RepRapLtd/Duet/Duet-1.0/moved-buck-peripherals_1024.png

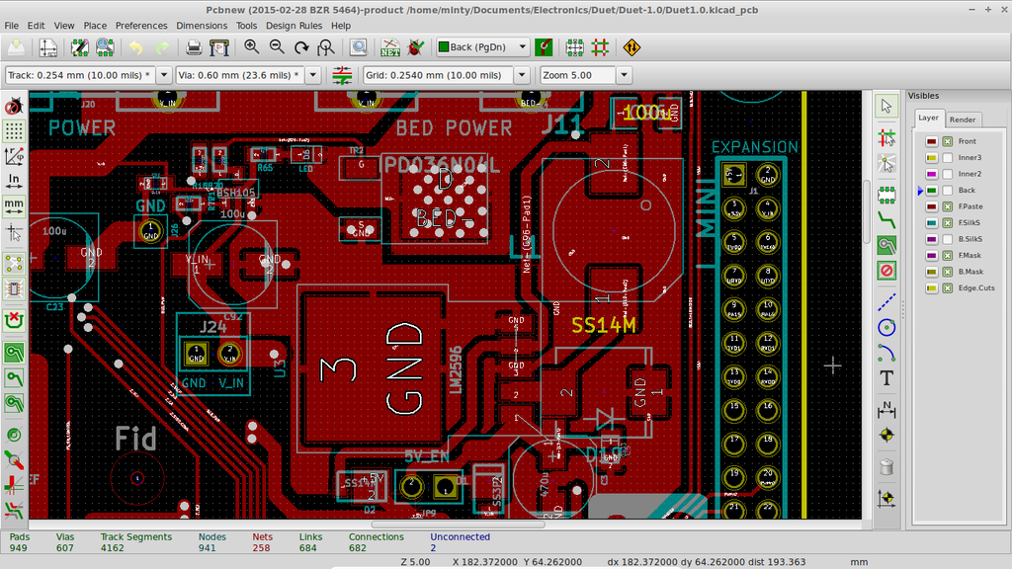
Duet-1.0/moved-buck-peripherals_1024.png
