RepRapLtd/Duet/Duet-1.0/buck-close-up.png

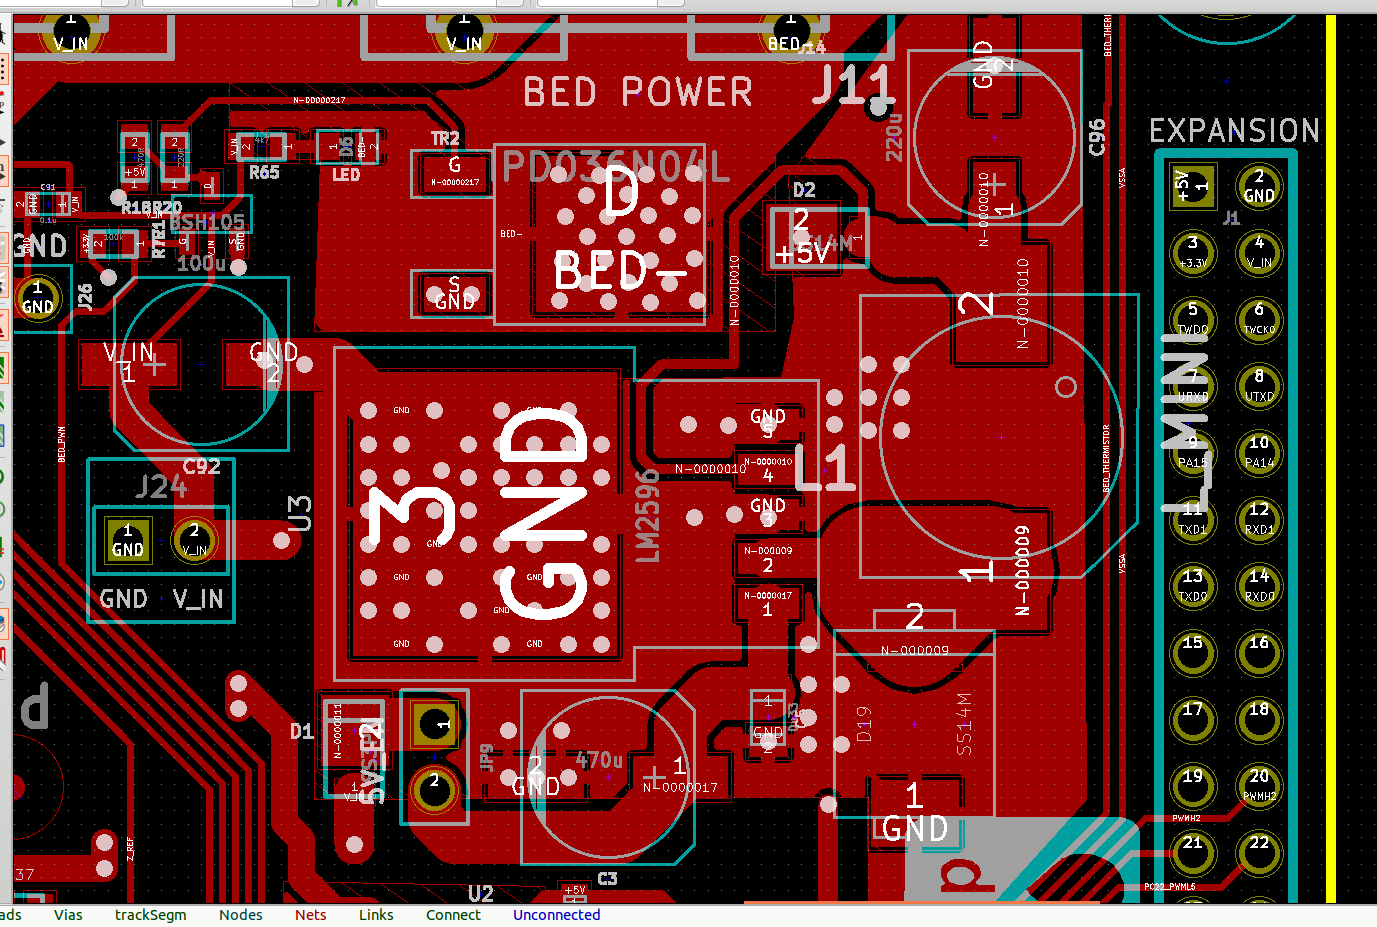
Duet-1.0/buck-close-up.png
