RepRapLtd/Duet/Duet-1.0/Duet1.0.csv

C1 | 10u | C_0805
C2 | 0u01 | C_0603
C3 | 220u | C_ELEC_10
C4 | 10u | C_0805
C5 | 0.33u | C_0805
C6 | 47n | C_0603
C7 | 10u | C_0805
C8 | 22p | C_0603
C9 | 22p | C_0603
C10 | 22u | C_1210
C11 | 22u | C_1210
C12 | 2u2 | C_0805
C13 | 1u | C_0603
C14 | 0u1 | C_0603
C15 | 0u1 | C_0603
C16 | 0u1 | C_0603
C17 | 0u1 | C_0603
C18 | 10u | C_0805
C19 | 10u | C_0805
C20 | 0u22 | C_0603
C21 | 0u22 | C_0603
C22 | 100u | C_ELEC_6.3x7.7
C23 | 100u | C_ELEC_6.3x7.7
C24 | 0u1 | C_0603
C25 | 0u1 | C_0603
C26 | 0u22 | C_0603
C27 | 0u22 | C_0603
C28 | 0u1 | C_0603
C29 | 0u1 | C_0603
C30 | 0u22 | C_0603
C31 | 0u22 | C_0603
C32 | 100u | C_ELEC_6.3x7.7
C33 | 100u | C_ELEC_6.3x7.7
C34 | 0u1 | C_0603
C35 | 0u1 | C_0603
C36 | 0u22 | C_0603
C37 | 0u22 | C_0603
C38 | 0u1 | C_0603
C39 | 0u1 | C_0603
C40 | 0u1 | C_0603
C41 | 0u1 | C_0603
C42 | 0u1 | C_0603
C43 | 0u1 | C_0603
C44 | 10p | C_0603
C45 | 10p | C_0603
C46 | 0u1 | C_0603
C47 | 10u | C_0805
C48 | 0u1 | C_0603
C49 | 0u1 | C_0603
C50 | 0u1 | C_0603
C51 | 0u1 | C_0603
C52 | 0u1 | C_0603
C53 | 0u1 | C_0603
C54 | 47n | C_0603
C55 | 0u1 | C_0603
C56 | 0u1 | C_0603
C57 | 0u1 | C_0603
C58 | 2u2 | C_0805
C59 | 4u7 | C_0805
C60 | 0u1 | C_0603
C61 | 4u7 | C_0805
C62 | 0u1 | C_0603
C63 | 47n | C_0603
C64 | 0u1 | C_0603
C65 | 10p | C_0603
C66 | 4u7 | C_0805
C67 | 0u1 | C_0603
C68 | 4u7 | C_0805
C69 | 0u1 | C_0603
C70 | 0u1 | C_0603
C71 | 0u1 | C_0603
C72 | 0u1 | C_0603
C73 | 47n | C_0603
C74 | 47n | C_0603
C75 | 0u1 | C_0603
C76 | 0u1 | C_0603
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
U3 | LM2596 | TO-263-5
U4 | KSZ8051RNL | QFN32-5x5
U5 | A4982SLPTR | TSSOP-24
U6 | A4982SLPTR | TSSOP-24
U7 | A4982SLPTR | TSSOP-24
U8 | A4982SLPTR | TSSOP-24
U9 | MCP44X1 | TSSOP-20
U10 | SP2525A-1 | SOIC-8
X1 | CRYSTAL_4PIN | Xtal_5x3.2
X2 | CRYSTAL_4PIN | Xtal_5x3.2
