RepRapLtd/Duet/Duet-0.8/component-locations.txt

Erase and Reset: http://uk.mouser.com/ProductDetail/CK-Components/KMS221G-LFS/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
