RepRapLtd/Duet/Duet-1.0/Comms.sch

## KiCad design Duet-1.0/Comms.sch (2015-10-17)

Schematic: Comms.sch

Parts:
C7: 10u
C8, C9: 22p
C10, C11: 22u
C12, C58: 2u2
C13: 1u
C16, C17, C53: 0u1
D3: LED
D4, D5: TS4148
J15: uSDHC
J19: ETHERNET
J29: USB
L2: Ferrite Bead; 1206
R1: 680R
R2, R3: 39R 1%
R4, R5: 10k; 0603
R6, R7, R8, R9, R10: 33R; 0603
R11, R13: 1k; 0603
R12, R14: 4k7; 0603
R15: 6k49 1%; 0603
R16, R17: 220R; 0603
R53: 100k
R63, R64: 10K; 0603
R73, R74, R75, R76: 47K; 0603
R83: 0R
U4: KSZ8051RNL
U10: SP2525A-1
X1: CRYSTAL_4PIN

Notes on the sheet:
uSD
ETHERNET
USB
