RepRapLtd/Duet/Duet-1.0/Headers.sch

## KiCad design Duet-1.0/Headers.sch (2015-10-17)

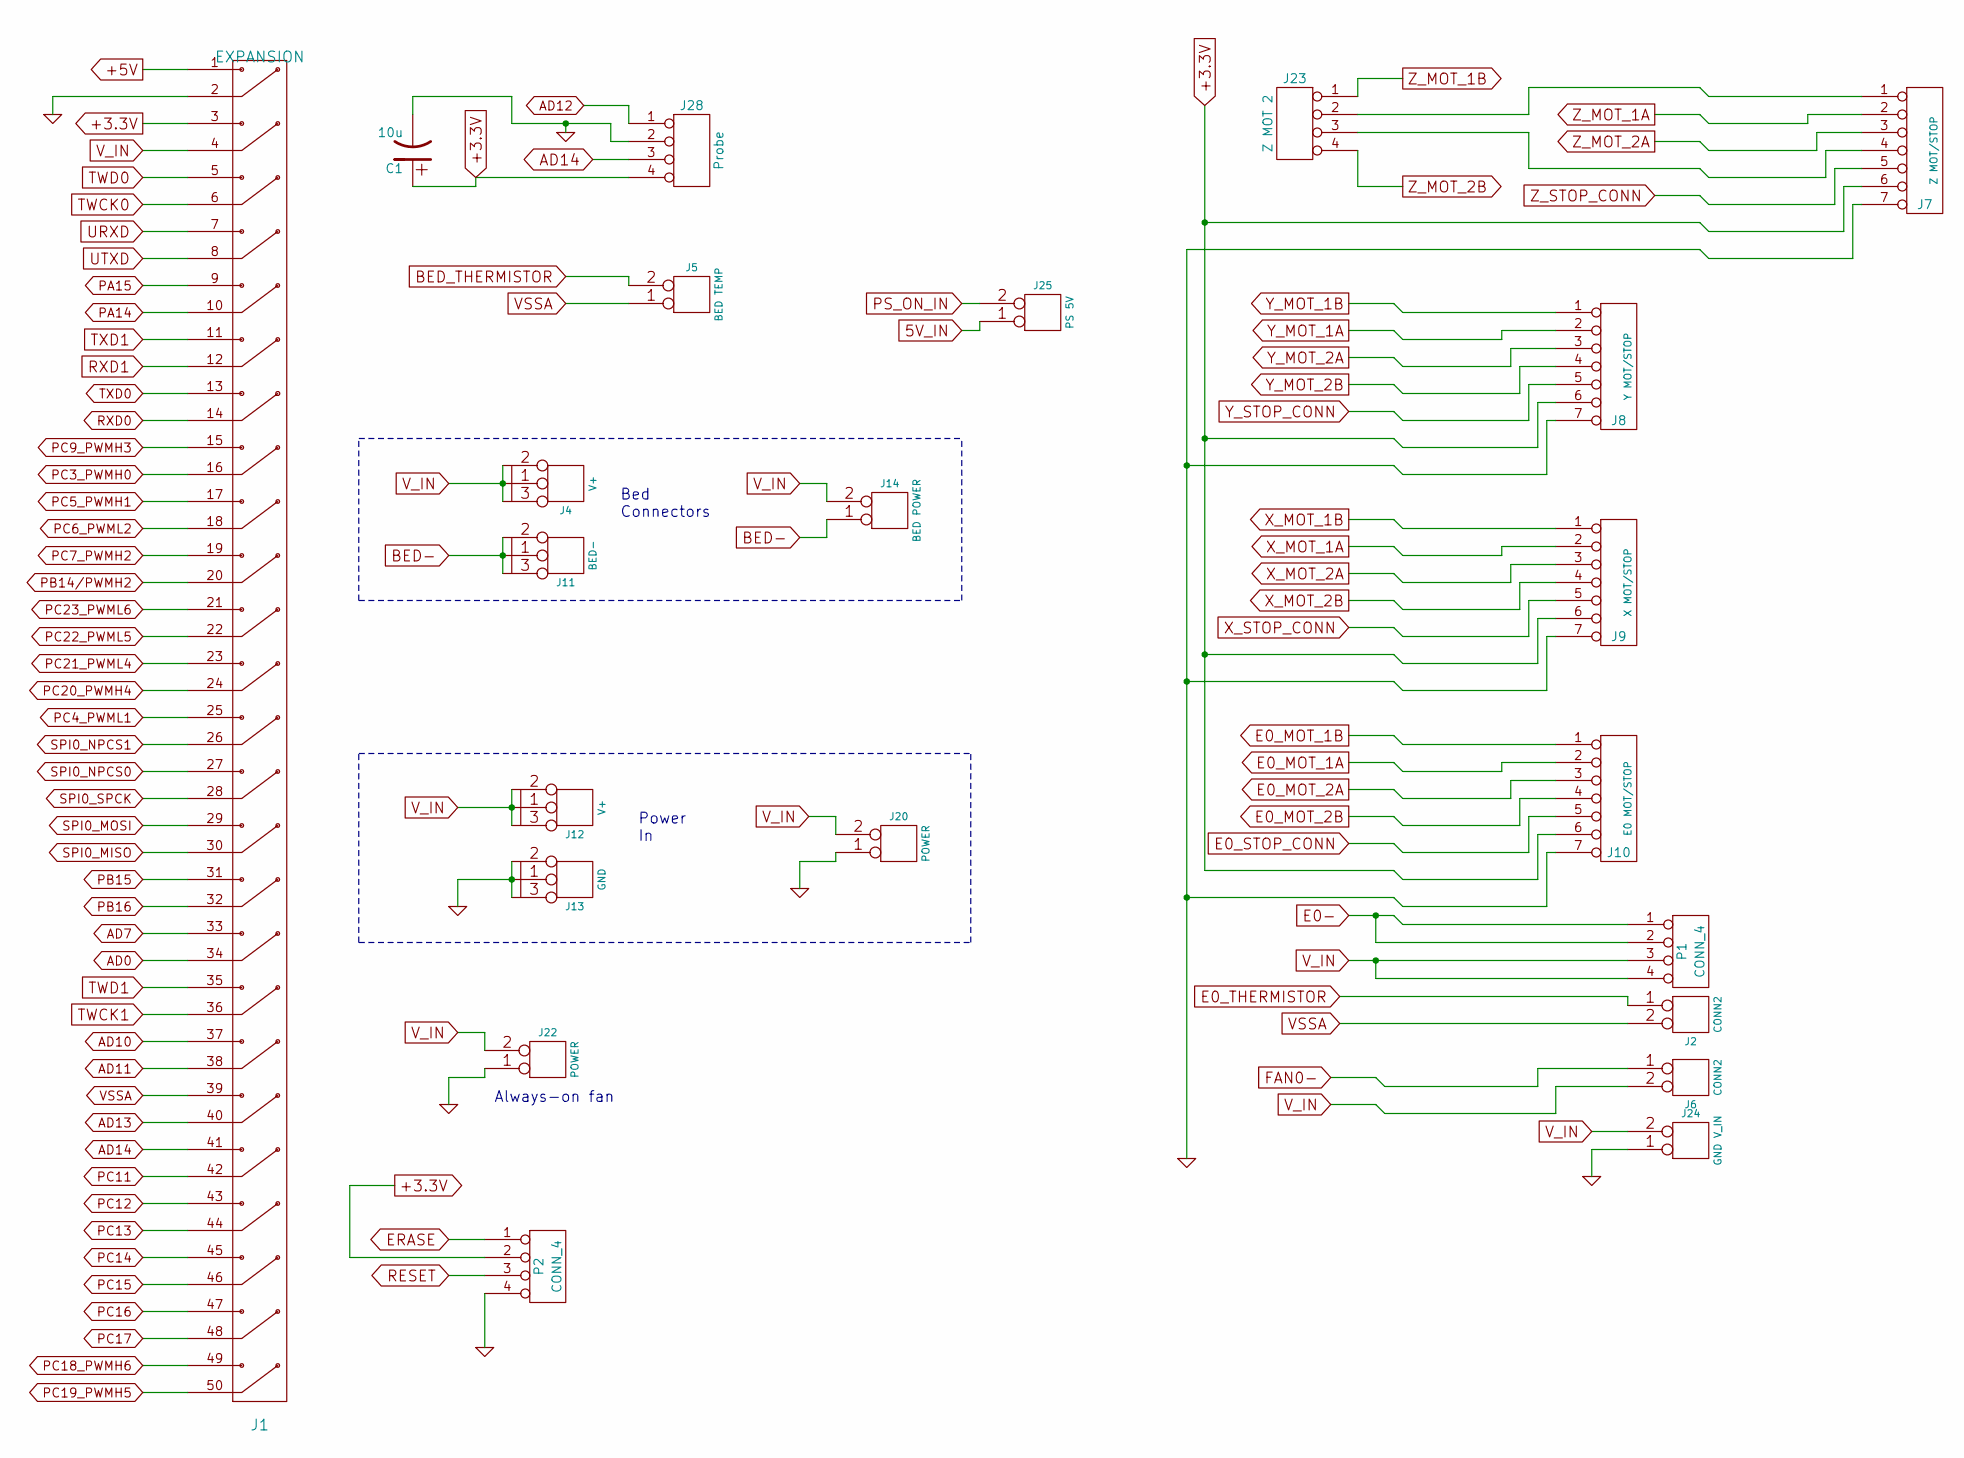
[picture p9: schematic Headers.sch]

Parts:
C1: 10u
J1: EXPANSION
J2, J6: CONN2
J4, J12: V+
J5: BED TEMP
J7: Z MOT/STOP
J8: Y MOT/STOP
J9: X MOT/STOP
J10: E0 MOT/STOP
J11: BED-
J13: GND
J14: BED POWER
J20, J22: POWER
J23: Z MOT 2
J24: GND V_IN
J25: PS 5V
J28: Probe
P1, P2: CONN_4

Connections:
5V_IN: J25.1
+3.3V: C1.1, J1.3, J7.6, J8.6, J9.6, J10.6, J28.4, P2.2
+5V: J1.1
AD0: J1.34
AD7: J1.33
AD10: J1.37
AD11: J1.38
AD12: J28.1
AD13: J1.40
AD14: J1.41, J28.3
BED-: J11.1, J11.2, J11.3, J14.1
BED_THERMISTOR: J5.2 (PM)
E0-: P1.1, P1.2
E0_MOT_1A: J10.2
E0_MOT_1B: J10.1
E0_MOT_2A: J10.3
E0_MOT_2B: J10.4
E0_STOP_CONN: J10.5
E0_THERMISTOR: J2.1
ERASE: P2.1
FAN0-: J6.1
GND: C1.2, J1.2, J7.7, J8.7, J9.7, J10.7, J13.1, J13.2, J13.3, J20.1, J22.1, J24.1, J28.2, P2.4
unnamed: J7.1, J23.2
unnamed: J7.4, J23.3
PA14: J1.10
PA15: J1.9
PB14/PWMH2: J1.20
PB15: J1.31
PB16: J1.32
PC3_PWMH0: J1.16
PC4_PWML1: J1.25
PC5_PWMH1: J1.17
PC6_PWML2: J1.18
PC7_PWMH2: J1.19
PC9_PWMH3: J1.15
PC11: J1.42
PC12: J1.43
PC13: J1.44
PC14: J1.45
PC15: J1.46
PC16: J1.47
PC17: J1.48
PC18_PWMH6: J1.49
PC19_PWMH5: J1.50
PC20_PWMH4: J1.24
PC21_PWML4: J1.23
PC22_PWML5: J1.22
PC23_PWML6: J1.21
PS_ON_IN: J25.2 (PM)
RESET: P2.3
RXD0: J1.14
RXD1: J1.12
SPI0_MISO: J1.30
SPI0_MOSI: J1.29
SPI0_NPCS0: J1.27
SPI0_NPCS1: J1.26
SPI0_SPCK: J1.28
TWCK0: J1.6
TWCK1: J1.36
TWD0: J1.5
TWD1: J1.35
TXD0: J1.13
TXD1: J1.11
URXD: J1.7
UTXD: J1.8
VSSA: J1.39, J2.2 (PM), J5.1
V_IN: J1.4, J4.1, J4.2, J4.3, J6.2 (PM), J12.1, J12.2, J12.3, J14.2 (PM), J20.2 (PM), J22.2 (PM), J24.2 (PM), P1.3, P1.4
X_MOT_1A: J9.2
X_MOT_1B: J9.1
X_MOT_2A: J9.3
X_MOT_2B: J9.4
X_STOP_CONN: J9.5
Y_MOT_1A: J8.2
Y_MOT_1B: J8.1
Y_MOT_2A: J8.3
Y_MOT_2B: J8.4
Y_STOP_CONN: J8.5
Z_MOT_1A: J7.2
Z_MOT_1B: J23.1
Z_MOT_2A: J7.3
Z_MOT_2B: J23.4
Z_STOP_CONN: J7.5

Notes on the sheet:
Bed Connectors
Power In
Always-on fan
