RepRapLtd/Duet/Duet-1.0/Htr_Fan.sch

## KiCad design Duet-1.0/Htr_Fan.sch (2015-10-17)

Schematic: Htr_Fan.sch

Parts:
C18, C19: 10u
C91: 0.1u
C92, C94: 100u
C93: 0u1
D6, D7, D8: LED
J27: TP
R18, R22, R24: 470R
R19, R21: 4K7
R20, R23, R25: 220R
R65, R67, R68: 4k7
R77, R78, R79: 100k
TR1, TR3, TR5: BSH105
TR2, TR4, TR6: IPD036N04L

Notes on the sheet:
THERMISTOR INPUTS
FAN MOSFET CONTROL
E0 MOSFET CONTROL
BED MOSFET CONTROL
