RepRapLtd/Duet/Duet-1.0/Processor.sch

## KiCad design Duet-1.0/Processor.sch (2015-10-17)

Schematic: Processor.sch

Parts:
C2: 0u01
C44, C45, C65: 10p
C46, C48, C49, C50, C51, C52, C60, C62, C64, C67, C69, C70, C71, C72: 0u1
C47: 10u
C59, C61, C66, C68: 4u7
C90: 10nF
J26: GND
L3, L4, L5, L6, L7: 100Mhz
R36, R49, R52: 100k
R48: 6k8
R62, R80, R81: 10K
U1: ATSAM3X8E; LQFP100
X2: CRYSTAL_4PIN

Notes on the sheet:
Integrates a permanent ~15K pullup resistor
SPI(0)
I2C(1)
VDDPLL
VDDCORE
VDDIO
VDDIN
