RepRapLtd/Duet/Duet-1.0/Stepper_Drv.sch

## KiCad design Duet-1.0/Stepper_Drv.sch (2015-10-17)

Schematic: Stepper_Drv.sch

Parts:
C6, C54, C63, C73, C74, C79, C80, C81, C82, C83, C84, C85, C86, C87, C88, C89: 47n
C14, C15, C24, C25, C28, C29, C34, C35, C38, C39, C40, C41, C42, C43, C55, C56, C57, C75, C76, C77, C78: 0u1
C20, C21, C26, C27, C30, C31, C36, C37: 0u22
C22, C23, C32, C33: 100u
D9, D10, D11, D12: LED
J3, J16, J17, J18: VREF
R26, R28, R40: 100k
R27, R29, R39, R41, R66: 10k
R30, R31, R42, R43: 0R
R32, R33, R34, R35, R44, R45, R46, R47: 0R1
R37: 2k7
R38: 100k; 0603
R50, R51: 4k7
R56, R57, R58, R59: 100R
R69, R70, R71, R72: 680R
SJ1, SJ3, SJ5, SJ7: MS2
SJ2, SJ4, SJ6, SJ8: MS1
U5, U6, U7, U8: A4982SLPTR
U9: MCP44X1

Notes on the sheet:
2k7 resistor chosen to give range of VRef with 0R1 sense resistors for full range of current, to use the maximum current cooling would be required.
Endstops.
Digital Current Limit Control
Z-Axis Stepper Driver
Extruder Stepper Driver
Y-Axis Stepper Driver
X-Axis Stepper Driver
