RepRapLtd/Duet/Shield-0.4/Headers.sch

## KiCad design Shield-0.4/Headers.sch (2015-07-09)

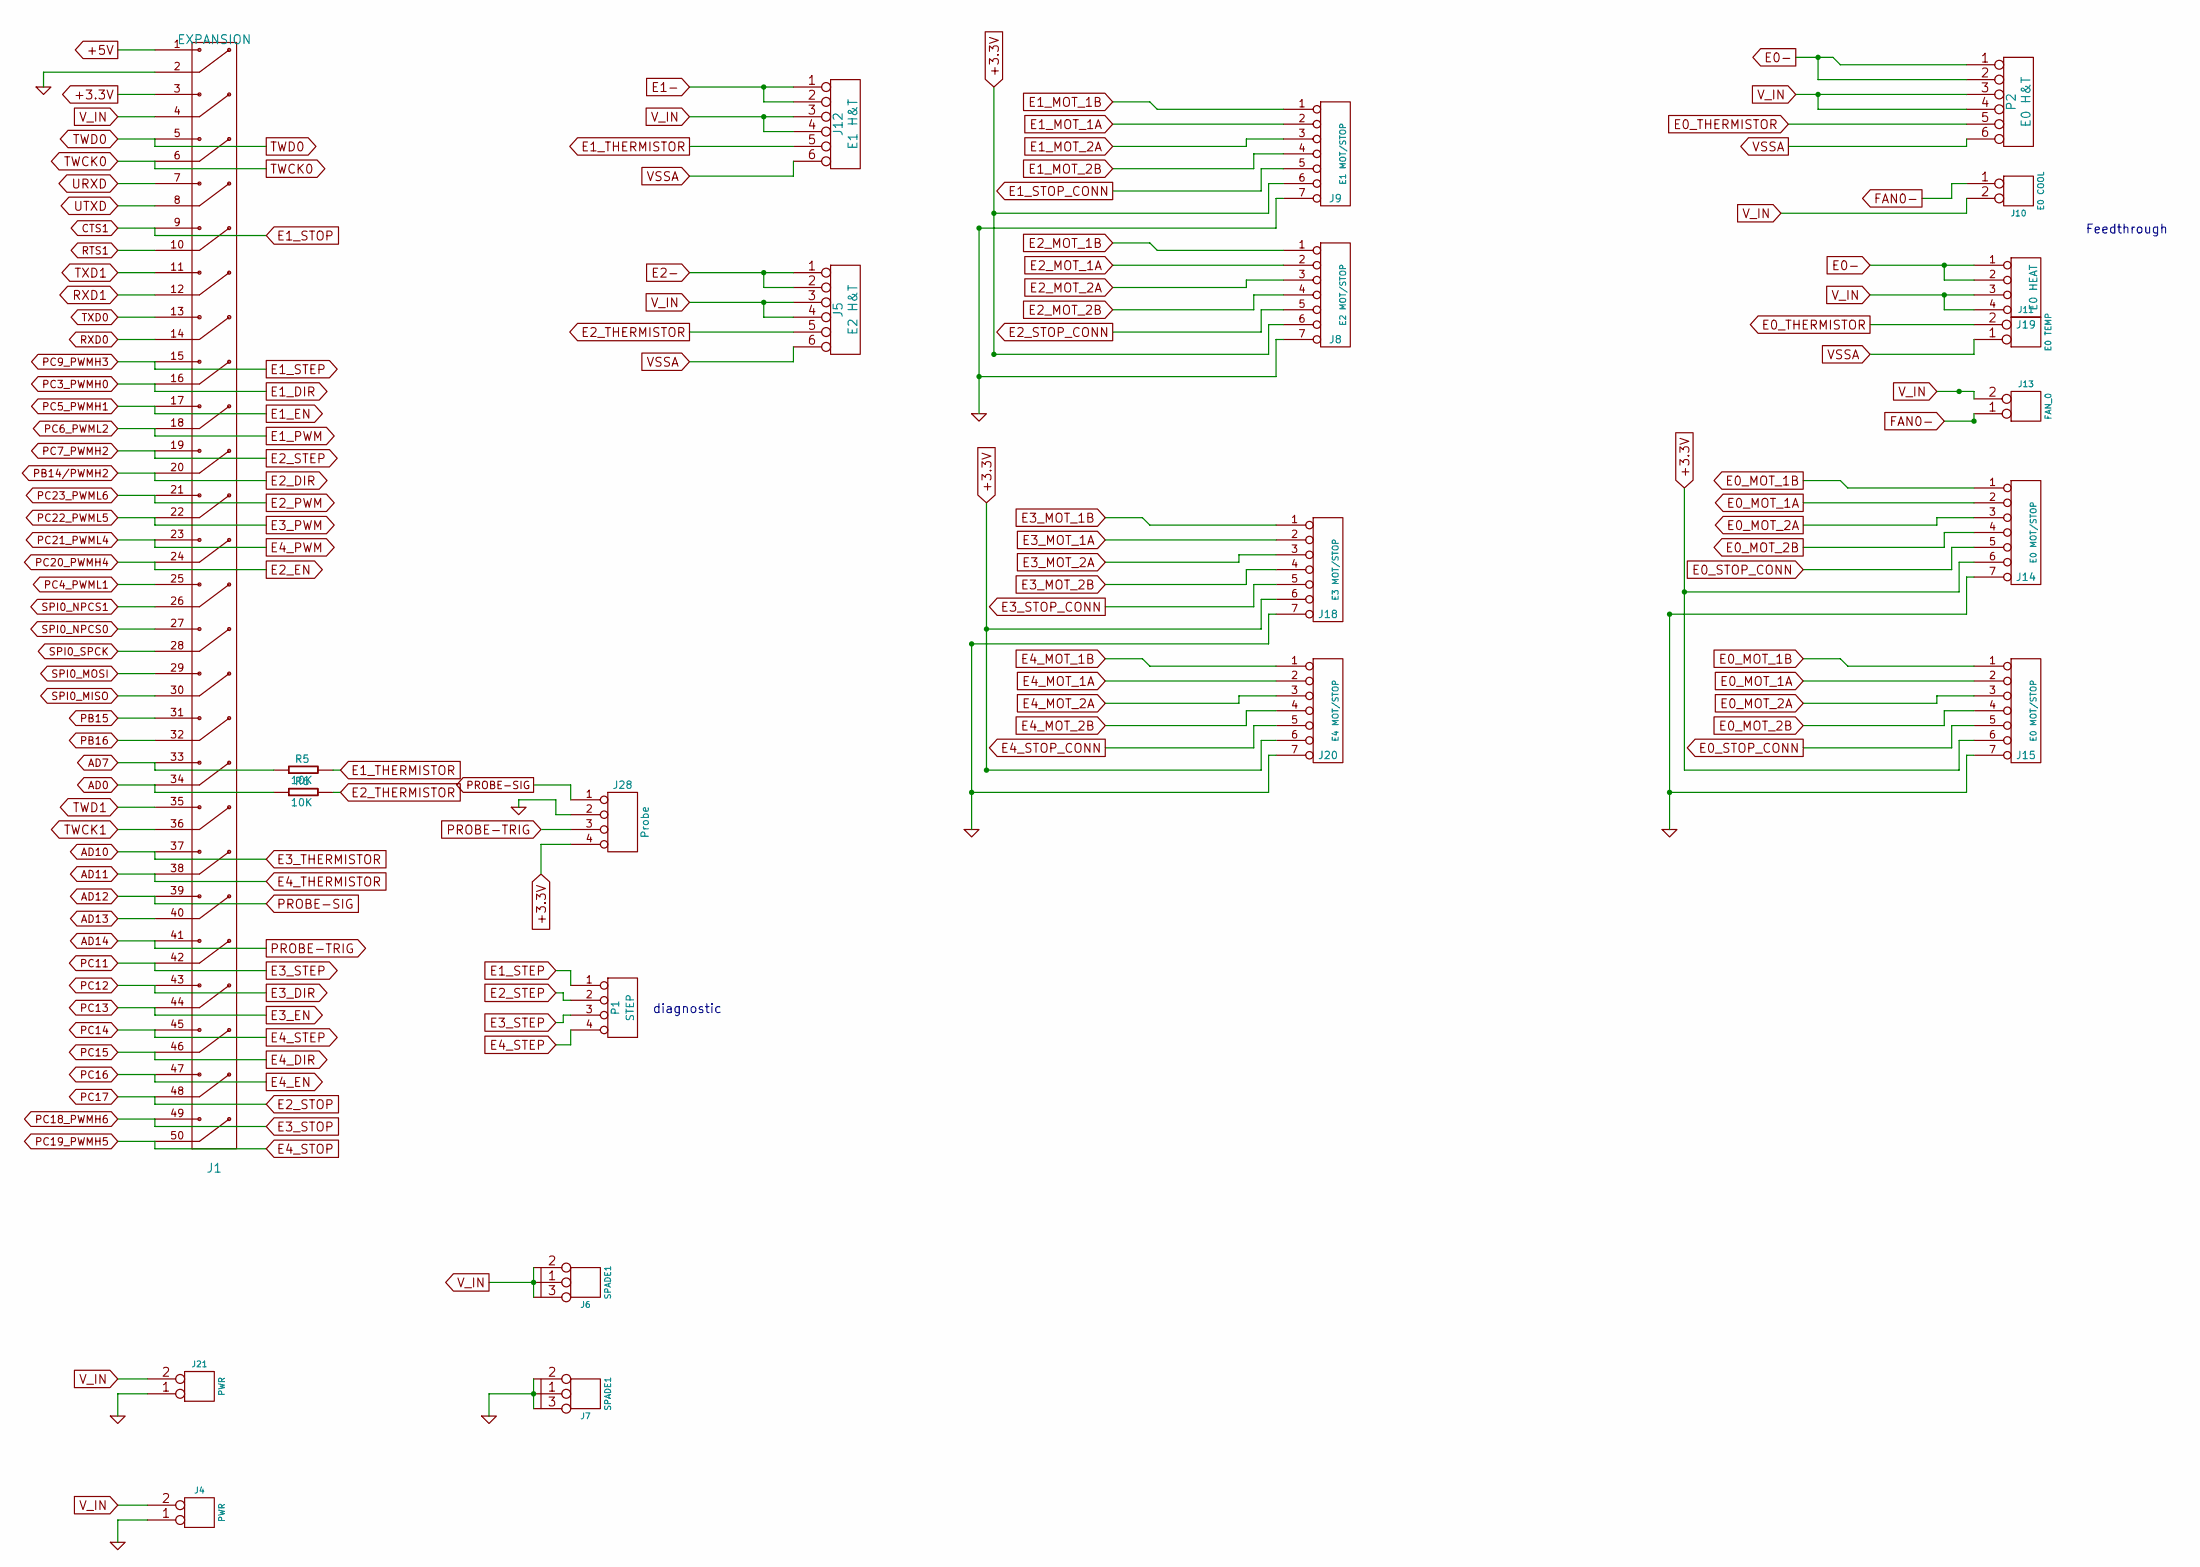
[picture p11: schematic Headers.sch]

Parts:
J1: EXPANSION
J4, J21: PWR
J5: E2 H&T
J6, J7: SPADE1
J8: E2 MOT/STOP
J9: E1 MOT/STOP
J10: E0 COOL
J11: E0 TEMP
J12: E1 H&T
J13: FAN_0
J14, J15: E0 MOT/STOP
J18: E3 MOT/STOP
J19: E0 HEAT
J20: E4 MOT/STOP
J28: Probe
P1: STEP
P2: E0 H&T
R5, R6: 10K

Connections:
+3.3V: J1.3, J8.6, J9.6, J14.6, J15.6, J18.6, J20.6, J28.4
+5V: J1.1
AD0: J1.34, R6.1
AD7: J1.33, R5.1
AD10: J1.37
AD11: J1.38
AD12: J1.39, J28.1
AD13: J1.40
AD14: J1.41, J28.3
CTS1: J1.9
E0-: J19.1, J19.2, P2.1, P2.2
E0_MOT_1A: J14.2, J15.2
E0_MOT_1B: J14.1, J15.1
E0_MOT_2A: J14.3, J15.3
E0_MOT_2B: J14.4, J15.4
E0_STOP_CONN: J14.5, J15.5
E0_THERMISTOR: J11.2 (PM), P2.5
E1-: J12.1, J12.2
E1_DIR: J1.16
E1_EN: J1.17
E1_MOT_1A: J9.2
E1_MOT_1B: J9.1
E1_MOT_2A: J9.3
E1_MOT_2B: J9.4
E1_PWM: J1.18
E1_STEP: J1.15, P1.1
E1_STOP_CONN: J9.5
E1_THERMISTOR: J12.5, R5.2
E2-: J5.1, J5.2
E2_DIR: J1.20
E2_EN: J1.24
E2_MOT_1A: J8.2
E2_MOT_1B: J8.1
E2_MOT_2A: J8.3
E2_MOT_2B: J8.4
E2_PWM: J1.21
E2_STEP: J1.19, P1.2
E2_STOP: J1.48
E2_STOP_CONN: J8.5
E2_THERMISTOR: J5.5, R6.2
E3_DIR: J1.43
E3_EN: J1.44
E3_MOT_1A: J18.2
E3_MOT_1B: J18.1
E3_MOT_2A: J18.3
E3_MOT_2B: J18.4
E3_PWM: J1.22
E3_STEP: J1.42, P1.3
E3_STOP: J1.49
E3_STOP_CONN: J18.5
E4_DIR: J1.46
E4_EN: J1.47
E4_MOT_1A: J20.2
E4_MOT_1B: J20.1
E4_MOT_2A: J20.3
E4_MOT_2B: J20.4
E4_PWM: J1.23
E4_STEP: J1.45, P1.4
E4_STOP: J1.50
E4_STOP_CONN: J20.5
FAN0-: J10.1, J13.1
GND: J1.2, J4.1, J7.1, J7.2, J7.3, J8.7, J9.7, J14.7, J15.7, J18.7, J20.7, J21.1, J28.2
PB15: J1.31
PB16: J1.32
PC4_PWML1: J1.25
RTS1: J1.10
RXD0: J1.14
RXD1: J1.12
SPI0_MISO: J1.30
SPI0_MOSI: J1.29
SPI0_NPCS0: J1.27
SPI0_NPCS1: J1.26
SPI0_SPCK: J1.28
TWCK0: J1.6
TWCK1: J1.36
TWD0: J1.5
TWD1: J1.35
TXD0: J1.13
TXD1: J1.11
URXD: J1.7
UTXD: J1.8
VSSA: J5.6, J11.1, J12.6, P2.6
V_IN: J1.4, J4.2 (PM), J5.3, J5.4, J6.1, J6.2, J6.3, J10.2 (PM), J12.3, J12.4, J13.2 (PM), J19.3, J19.4, J21.2 (PM), P2.3, P2.4

Notes on the sheet:
diagnostic
Feedthrough
