RepRapLtd/Duet/Shield-0.4/Htr_Fan.sch

## KiCad design Shield-0.4/Htr_Fan.sch (2015-07-09)

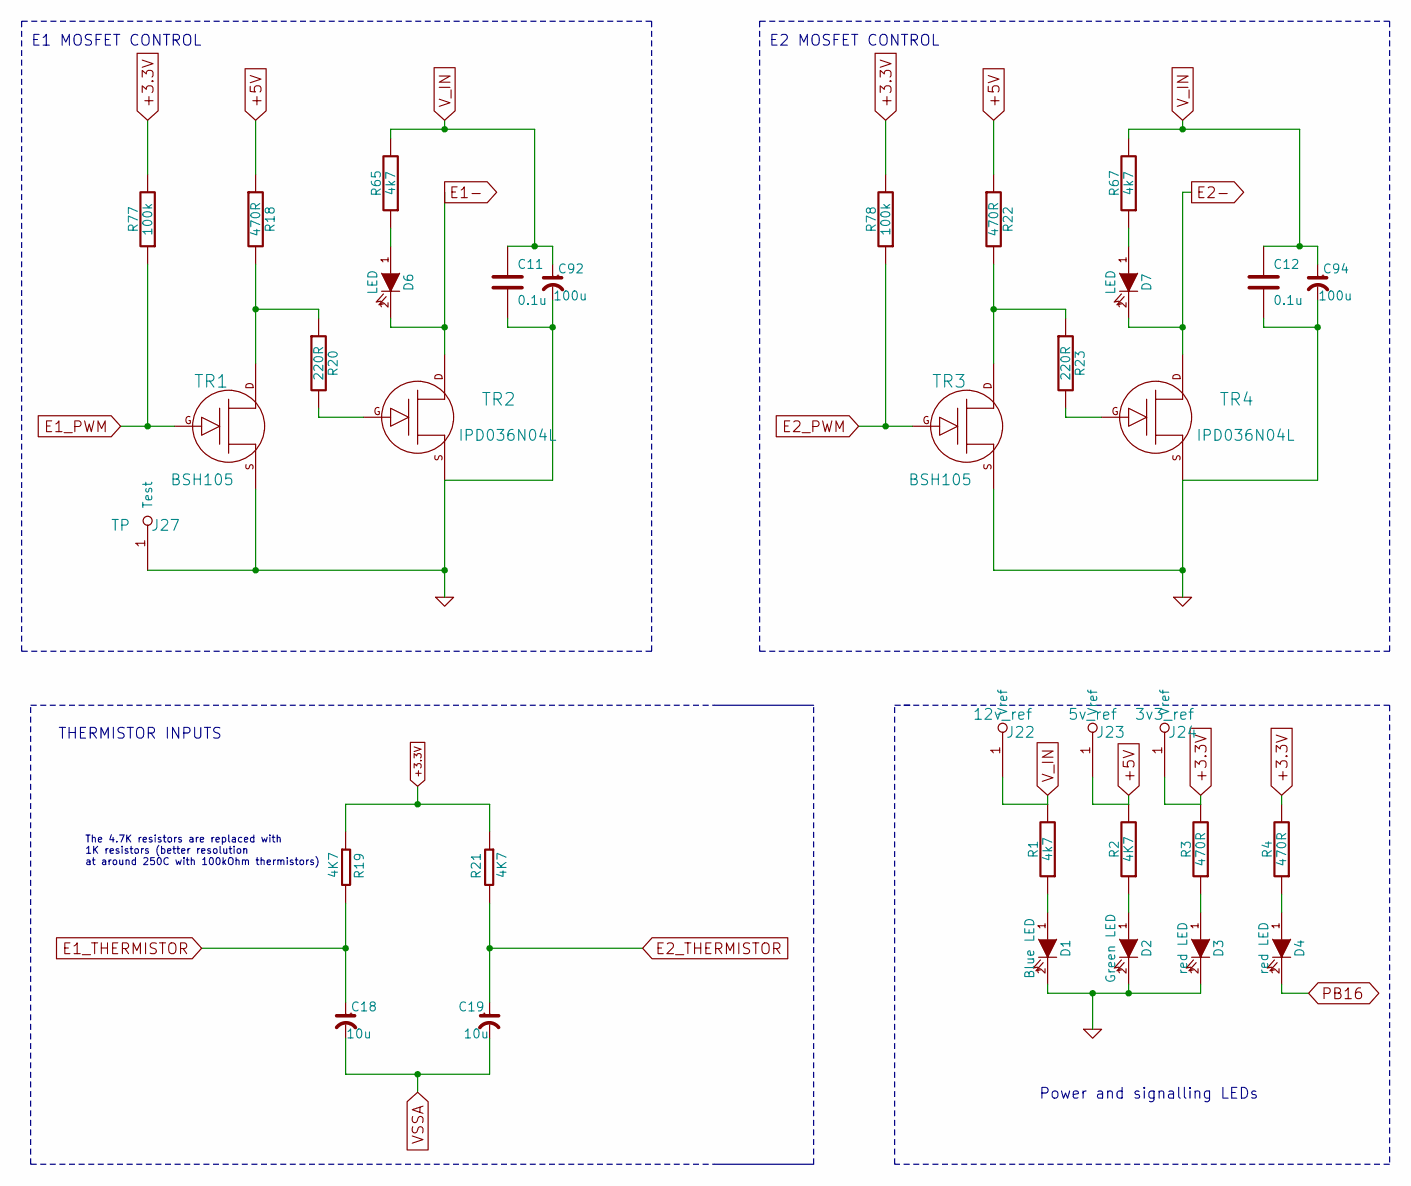
[picture p12: schematic Htr_Fan.sch]

Parts:
C11, C12: 0.1u
C18, C19: 10u
C92, C94: 100u
D1: Blue LED
D2: Green LED
D3, D4: red LED
D6, D7: LED
J22: 12v_ref
J23: 5v_ref
J24: 3v3_ref
J27: TP
R1, R65, R67: 4k7
R2, R19, R21: 4K7
R3, R4, R18, R22: 470R
R20, R23: 220R
R77, R78: 100k
TR1, TR3: BSH105
TR2, TR4: IPD036N04L

Connections:
+3.3V: J24.1, R3.2, R4.2, R19.1, R21.1, R77.2, R78.2
+5V: J23.1, R2.2, R18.1, R22.1
E1-: D6.2 (K), TR2.D
E1_PWM: R77.1, TR1.G
E1_THERMISTOR: C18.1, R19.2
E2-: D7.2 (K), TR4.D
E2_PWM: R78.1, TR3.G
E2_THERMISTOR: C19.1, R21.2
GND: C11.2, C12.2, C92.2, C94.2, D1.2 (K), D2.2 (K), D3.2 (K), J27.1, TR1.S, TR2.S, TR3.S, TR4.S
unnamed: D1.1 (A), R1.1
unnamed: D2.1 (A), R2.1
unnamed: D3.1 (A), R3.1
unnamed: D4.1 (A), R4.1
unnamed: D6.1 (A), R65.1
unnamed: D7.1 (A), R67.1
unnamed: R18.2, R20.1, TR1.D
unnamed: R20.2, TR2.G
unnamed: R22.2, R23.1, TR3.D
unnamed: R23.2, TR4.G
PB16: D4.2 (K)
VSSA: C18.2, C19.2
V_IN: C11.1, C12.1, C92.1, C94.1, J22.1, R1.2, R65.2, R67.2

Notes on the sheet:
The 4.7K resistors are replaced with 1K resistors (better resolution at around 250C with 100kOhm thermistors)
THERMISTOR INPUTS
E2 MOSFET CONTROL
E1 MOSFET CONTROL
Power and signalling LEDs
