RepRapLtd/Duet/Shield-0.4/Stepper_Drv.sch

## KiCad design Shield-0.4/Stepper_Drv.sch (2015-07-09)

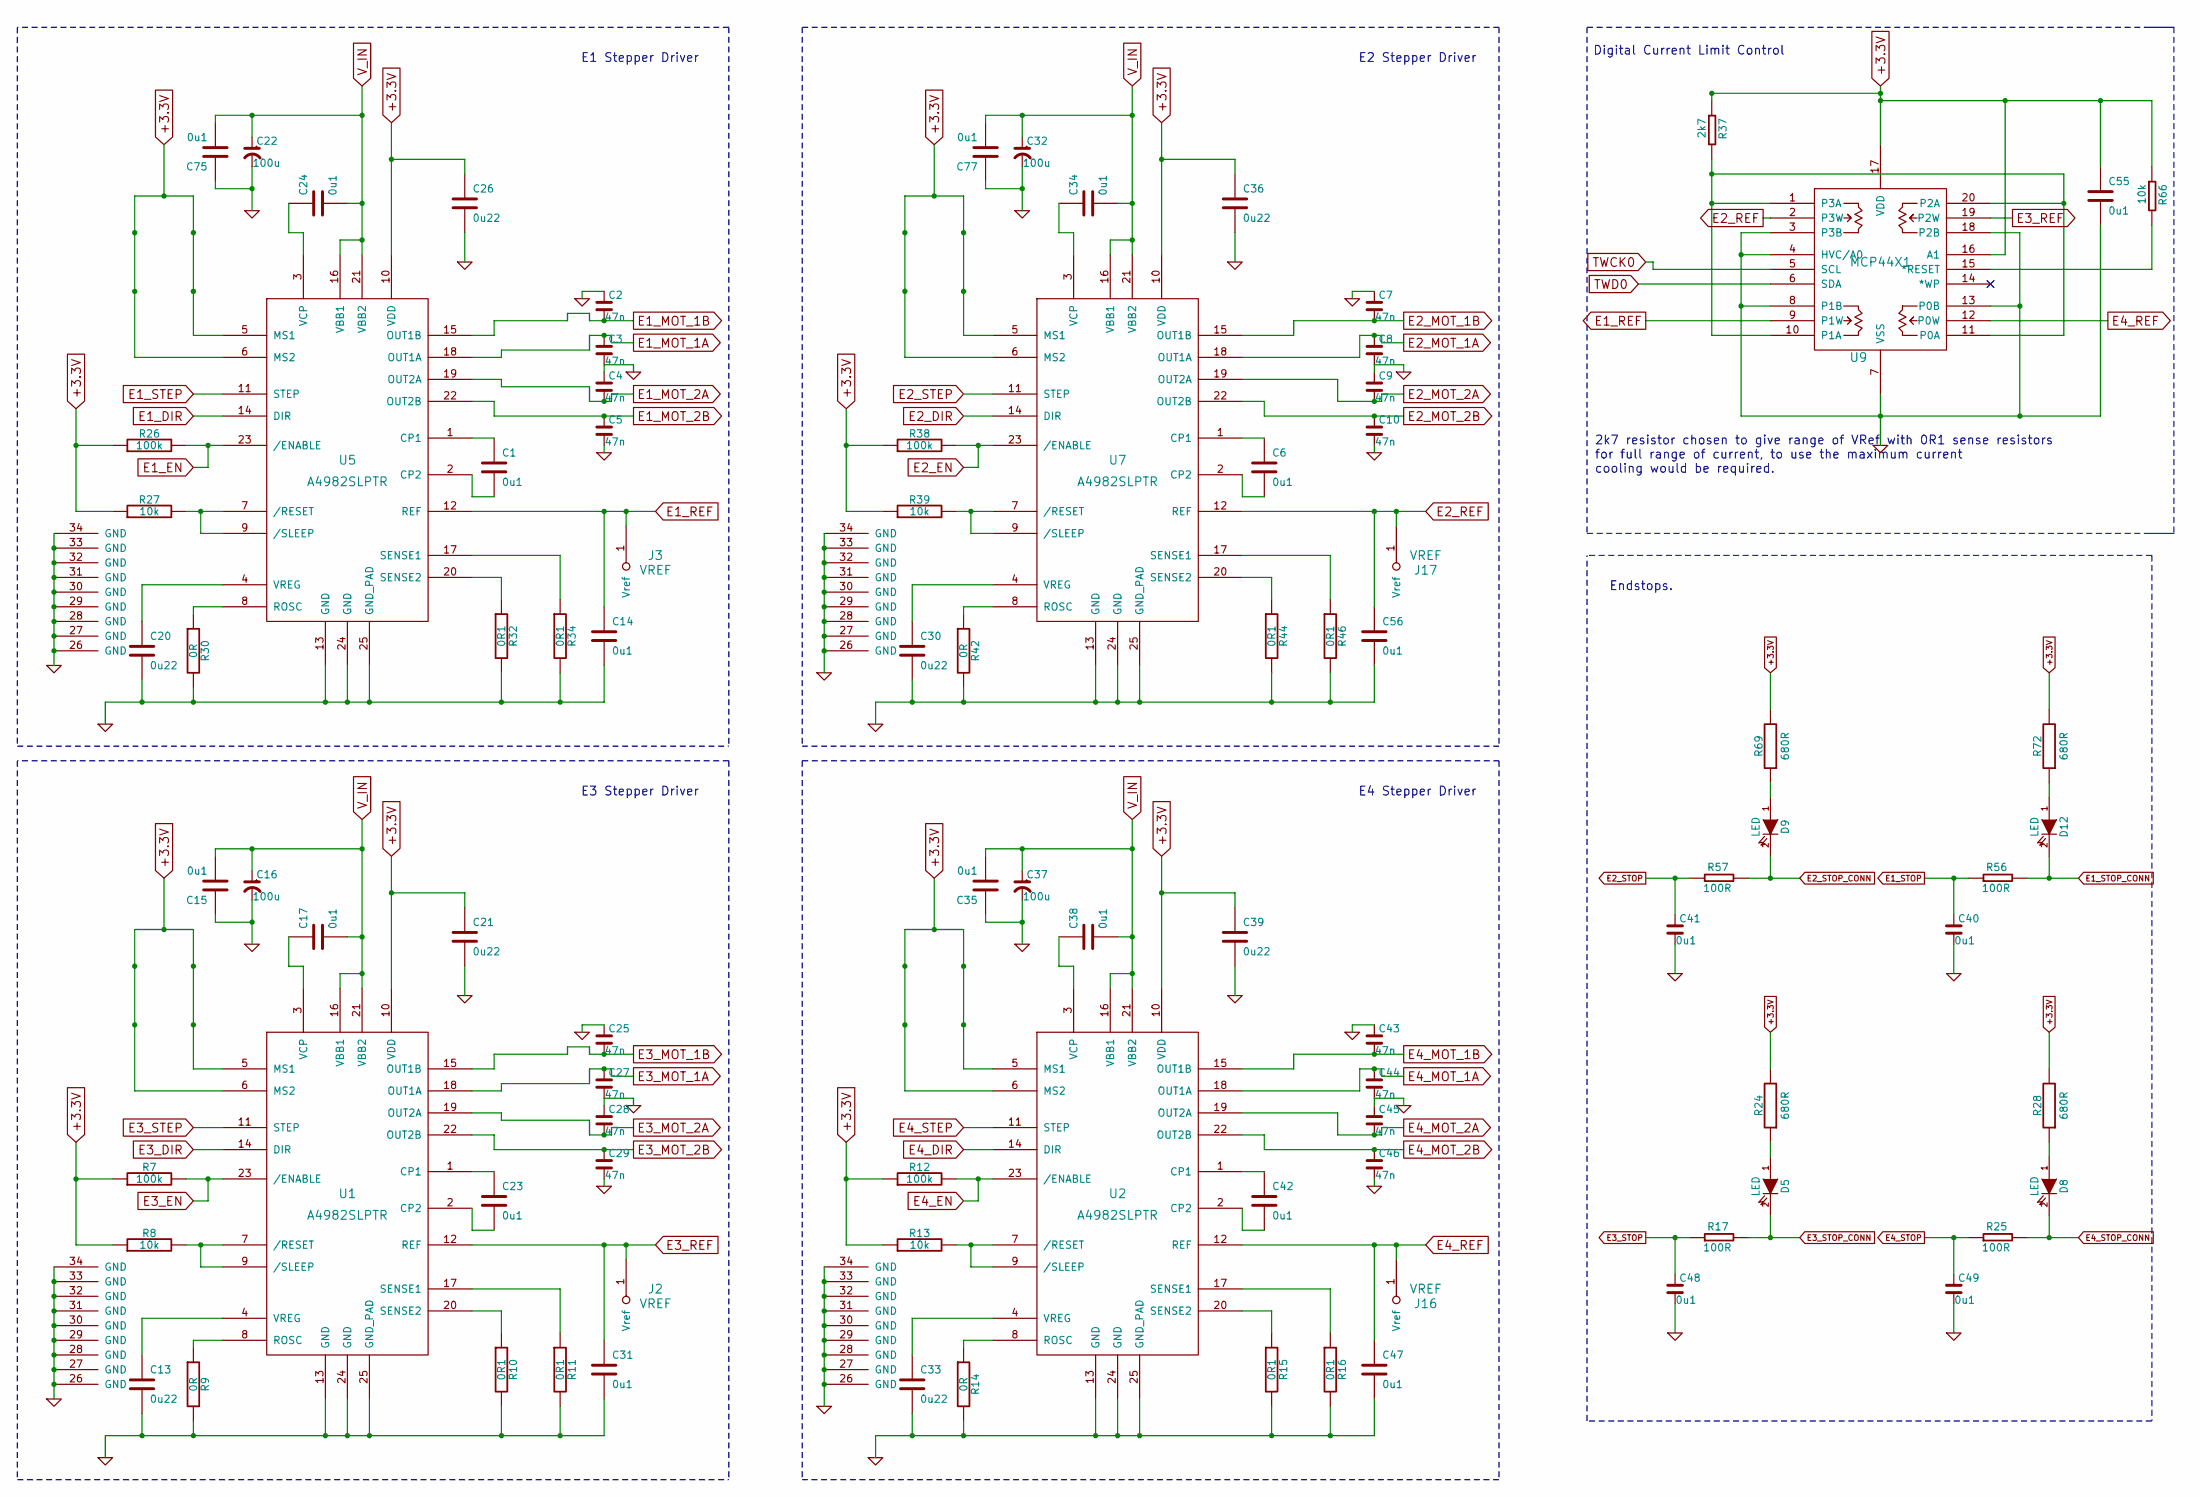
[picture p13: schematic Stepper_Drv.sch]

Parts:
C1, C6, C14, C15, C17, C23, C24, C31, C34, C35, C38, C40, C41, C42, C47, C48, C49, C55, C56, C75, C77: 0u1
C2, C3, C4, C5, C7, C8, C9, C10, C25, C27, C28, C29, C43, C44, C45, C46: 47n
C13, C20, C21, C26, C30, C33, C36, C39: 0u22
C16, C22, C32, C37: 100u
D5, D8, D9, D12: LED
J2, J3, J16, J17: VREF
R7, R26: 100k
R8, R13, R27, R39, R66: 10k
R9, R14, R30, R42: 0R
R10, R11, R15, R16, R32, R34, R44, R46: 0R1
R12, R38: 100k; 0603
R17, R25, R56, R57: 100R
R24, R28, R69, R72: 680R
R37: 2k7
U1, U2, U5, U7: A4982SLPTR
U9: MCP44X1

Connections:
+3.3V: C21.1, C26.1, C36.1, C39.1, C55.1, R7.1, R8.1, R12.1, R13.1, R24.2, R26.1, R27.1, R28.2, R37.1, R38.1, R39.1, R66.1, R69.2, R72.2, U1.5 (MS1), U1.6 (MS2), U1.10 (VDD), U2.5 (MS1), U2.6 (MS2), U2.10 (VDD), U5.5 (MS1), U5.6 (MS2), U5.10 (VDD), U7.5 (MS1), U7.6 (MS2), U7.10 (VDD), U9.16 (A1), U9.17 (VDD)
E1_DIR: U5.14 (DIR)
E1_EN: R26.2, U5.23 (/ENABLE)
E1_MOT_1A: C3.1, U5.18 (OUT1A)
E1_MOT_1B: C2.2, U5.15 (OUT1B)
E1_MOT_2A: C4.2, U5.19 (OUT2A)
E1_MOT_2B: C5.1, U5.22 (OUT2B)
E1_REF: C14.1, J3.1, U5.12 (REF), U9.9 (P1W)
E1_STEP: U5.11 (STEP)
E1_STOP: C40.1, R56.1
E1_STOP_CONN: D12.2 (K), R56.2
E2_DIR: U7.14 (DIR)
E2_EN: R38.2, U7.23 (/ENABLE)
E2_MOT_1A: C8.1, U7.18 (OUT1A)
E2_MOT_1B: C7.2, U7.15 (OUT1B)
E2_MOT_2A: C9.2, U7.19 (OUT2A)
E2_MOT_2B: C10.1, U7.22 (OUT2B)
E2_REF: C56.1, J17.1, U7.12 (REF), U9.2 (P3W)
E2_STEP: U7.11 (STEP)
E2_STOP: C41.1, R57.1
E2_STOP_CONN: D9.2 (K), R57.2
E3_DIR: U1.14 (DIR)
E3_EN: R7.2, U1.23 (/ENABLE)
E3_MOT_1A: C27.1, U1.18 (OUT1A)
E3_MOT_1B: C25.2, U1.15 (OUT1B)
E3_MOT_2A: C28.2, U1.19 (OUT2A)
E3_MOT_2B: C29.1, U1.22 (OUT2B)
E3_REF: C31.1, J2.1, U1.12 (REF), U9.19 (P2W)
E3_STEP: U1.11 (STEP)
E3_STOP: C48.1, R17.1
E3_STOP_CONN: D5.2 (K), R17.2
E4_DIR: U2.14 (DIR)
E4_EN: R12.2, U2.23 (/ENABLE)
E4_MOT_1A: C44.1, U2.18 (OUT1A)
E4_MOT_1B: C43.2, U2.15 (OUT1B)
E4_MOT_2A: C45.2, U2.19 (OUT2A)
E4_MOT_2B: C46.1, U2.22 (OUT2B)
E4_REF: C47.1, J16.1, U2.12 (REF), U9.12 (P0W)
E4_STEP: U2.11 (STEP)
E4_STOP: C49.1, R25.1
E4_STOP_CONN: D8.2 (K), R25.2
GND: C2.1, C3.2, C4.1, C5.2, C7.1, C8.2, C9.1, C10.2, C13.2, C14.2, C15.1, C16.2, C20.2, C21.2, C22.2, C25.1, C26.2, C27.2, C28.1, C29.2, C30.2, C31.2, C32.2, C33.2, C35.1, C36.2, C37.2, C39.2, C40.2, C41.2, C43.1, C44.2, C45.1, C46.2, C47.2, C48.2, C49.2, C55.2, C56.2, C75.1, C77.1, R9.2, R10.2, R11.2, R14.2, R15.2, R16.2, R30.2, R32.2, R34.2, R42.2, R44.2, R46.2, U1.13 (GND), U1.24 (GND), U1.25 (GND_PAD), U1.26 (GND), U1.27 (GND), U1.28 (GND), U1.29 (GND), U1.30 (GND), U1.31 (GND), U1.32 (GND), U1.33 (GND), U1.34 (GND), U2.13 (GND), U2.24 (GND), U2.25 (GND_PAD), U2.26 (GND), U2.27 (GND), U2.28 (GND), U2.29 (GND), U2.30 (GND), U2.31 (GND), U2.32 (GND), U2.33 (GND), U2.34 (GND), U5.13 (GND), U5.24 (GND), U5.25 (GND_PAD), U5.26 (GND), U5.27 (GND), U5.28 (GND), U5.29 (GND), U5.30 (GND), U5.31 (GND), U5.32 (GND), U5.33 (GND), U5.34 (GND), U7.13 (GND), U7.24 (GND), U7.25 (GND_PAD), U7.26 (GND), U7.27 (GND), U7.28 (GND), U7.29 (GND), U7.30 (GND), U7.31 (GND), U7.32 (GND), U7.33 (GND), U7.34 (GND), U9.3 (P3B), U9.4 (HVC/A0), U9.7 (VSS), U9.8 (P1B), U9.13 (P0B), U9.18 (P2B)
unnamed: C1.1, U5.1 (CP1)
unnamed: C1.2, U5.2 (CP2)
unnamed: C6.1, U7.1 (CP1)
unnamed: C6.2, U7.2 (CP2)
unnamed: C13.1, U1.4 (VREG)
unnamed: C17.1, U1.3 (VCP)
unnamed: C20.1, U5.4 (VREG)
unnamed: C23.1, U1.1 (CP1)
unnamed: C23.2, U1.2 (CP2)
unnamed: C24.1, U5.3 (VCP)
unnamed: C30.1, U7.4 (VREG)
unnamed: C33.1, U2.4 (VREG)
unnamed: C34.1, U7.3 (VCP)
unnamed: C38.1, U2.3 (VCP)
unnamed: C42.1, U2.1 (CP1)
unnamed: C42.2, U2.2 (CP2)
unnamed: D5.1 (A), R24.1
unnamed: D8.1 (A), R28.1
unnamed: D9.1 (A), R69.1
unnamed: D12.1 (A), R72.1
unnamed: R8.2, U1.7 (/RESET), U1.9 (/SLEEP)
unnamed: R9.1, U1.8 (ROSC)
unnamed: R10.1, U1.20 (SENSE2)
unnamed: R11.1, U1.17 (SENSE1)
unnamed: R13.2, U2.7 (/RESET), U2.9 (/SLEEP)
unnamed: R14.1, U2.8 (ROSC)
unnamed: R15.1, U2.20 (SENSE2)
unnamed: R16.1, U2.17 (SENSE1)
unnamed: R27.2, U5.7 (/RESET), U5.9 (/SLEEP)
unnamed: R30.1, U5.8 (ROSC)
unnamed: R32.1, U5.20 (SENSE2)
unnamed: R34.1, U5.17 (SENSE1)
unnamed: R37.2, U9.1 (P3A), U9.10 (P1A), U9.11 (P0A), U9.20 (P2A)
unnamed: R39.2, U7.7 (/RESET), U7.9 (/SLEEP)
unnamed: R42.1, U7.8 (ROSC)
unnamed: R44.1, U7.20 (SENSE2)
unnamed: R46.1, U7.17 (SENSE1)
unnamed: R66.2, U9.15 (*RESET)
TWCK0: U9.5 (SCL)
TWD0: U9.6 (SDA)
V_IN: C15.2, C16.1, C17.2, C22.1, C24.2, C32.1, C34.2, C35.2, C37.1, C38.2, C75.2, C77.2, U1.16 (VBB1), U1.21 (VBB2), U2.16 (VBB1), U2.21 (VBB2), U5.16 (VBB1), U5.21 (VBB2), U7.16 (VBB1), U7.21 (VBB2)

Notes on the sheet:
2k7 resistor chosen to give range of VRef with 0R1 sense resistors for full range of current, to use the maximum current cooling would be required.
Endstops.
Digital Current Limit Control
E2 Stepper Driver
E1 Stepper Driver
E4 Stepper Driver
E3 Stepper Driver
