RepRapLtd/Duet/Archive_Files/Duet-0.8/Power.sch

## KiCad design Archive_Files/Duet-0.8/Power.sch (2015-07-17, an earlier design)

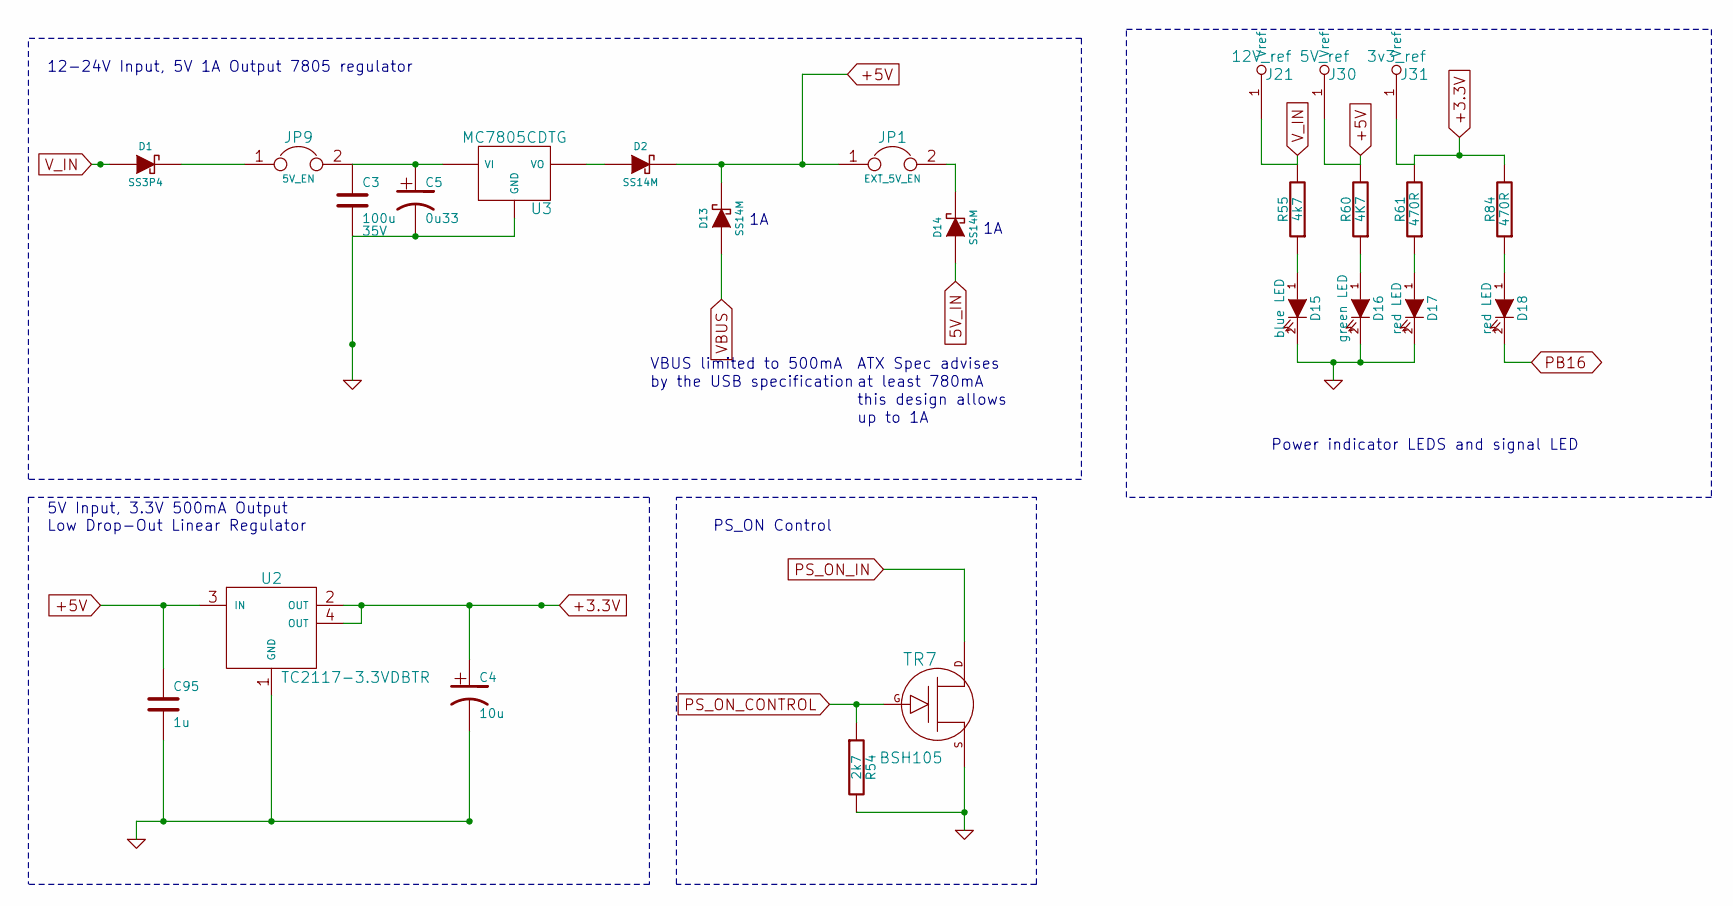
[picture p14: schematic Power.sch]

Parts:
C3: 100u; Voltage 35V
C4: 10u
C5: 0u33
C95: 1u
D1: SS3P4
D2, D13, D14: SS14M
D15: blue LED
D16: green LED
D17, D18: red LED
J21: 12V_ref
J30: 5V_ref
J31: 3v3_ref
JP1: EXT_5V_EN
JP9: 5V_EN
R54: 2k7
R55: 4k7
R60: 4K7
R61, R84: 470R
TR7: BSH105
U2: TC2117-3.3VDBTR
U3: MC7805CDTG

Connections:
5V_IN: D14.1 (A)
+3.3V: C4.1, J31.1, R61.2, R84.2, U2.2 (OUT), U2.4 (OUT)
+5V: C95.1, D2.2 (K), D13.2 (K), J30.1, JP1.1, R60.2, U2.3 (IN)
GND: C3.2, C4.2, C5.2, C95.2, D15.2 (K), D16.2 (K), D17.2 (K), R54.2, TR7.S, U2.1 (GND), U3.GND
unnamed: C3.1, C5.1, JP9.2, U3.VI
unnamed: D1.2 (K), JP9.1
unnamed: D2.1 (A), U3.VO
unnamed: D14.2 (K), JP1.2
unnamed: D15.1 (A), R55.1
unnamed: D16.1 (A), R60.1
unnamed: D17.1 (A), R61.1
unnamed: D18.1 (A), R84.1
PB16: D18.2 (K)
PS_ON_CONTROL: R54.1, TR7.G
PS_ON_IN: TR7.D
VBUS: D13.1 (A)
V_IN: D1.1 (A), J21.1, R55.2

Notes on the sheet:
PS_ON Control
up to 1A
this design allows
at least 780mA
ATX Spec advises
by the USB specification
VBUS limited to 500mA
5V Input, 3.3V 500mA Output Low Drop-Out Linear Regulator
12-24V Input, 5V 1A Output 7805 regulator
Power indicator LEDS and signal LED
