RepRapLtd/Duet/(commit log)

2015-04-22 Shield Gerber files corrected.
    [Shield-B_Mask.gbs, Shield-B_SilkS.gbo, Shield-Back.gbl, Shield-Edge_Cuts.gbr, Shield-F_Mask.gts, Shield-F_Paste.gtp, Shield-F_SilkS.gto, Shield-Front.gtl]
2015-06-11 Error in R26 size (it should be 0603) spotted by Wany corrected.
    [Headers.sch, Htr_Fan.sch, Shield-bom.csv, Shield.sch, Stepper_Drv.sch]
2015-06-23 Duet 0.8 Fan0, E0 heater and thermistor pins made compatible with Duet 0.6.
    [Duet0.8-B_Mask.gbs, Duet0.8-B_SilkS.gbo, Duet0.8-Back.gbl, Duet0.8-Edge_Cuts.gbr, Duet0.8-F_Mask.gts, Duet0.8-F_Paste.gtp, Duet0.8-F_SilkS.gto, Duet0.8-Front.gtl]
2015-07-08 USB B connector used. Always-on fan connector added next to heater connector. Green power LED (5v) now has a bigger ballast resistor.
    [Comms.sch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]
2015-07-08 Erase and Reset buttons replaced by jumpers.
    [Comms.sch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]
2015-07-09 Reset pin on the expansion header changed to V_IN now we have a reset pin on the board. There was no V_IN on that header before, and it would be useful.
    [Comms.sch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]
2015-07-09 Duet 0.8 power voltage test points added. Ballast resistors on power LEDs changed to make each the same brightness (allowing for the fact that the human eye sees green as a lot brighter than blue or 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
    [Comms.sch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]
2015-07-09 Voltage test points added to Shield.
    [Duet0.8-B_Mask.gbs, Duet0.8-B_SilkS.gbo, Duet0.8-Back.gbl, Duet0.8-Edge_Cuts.gbr, Duet0.8-F_Mask.gts, Duet0.8-F_Paste.gtp, Duet0.8-F_SilkS.gto, Duet0.8-Front.gtl]
2015-07-09 File tidying.
    [Shield-B_Cu.gbl, Shield-B_Mask.gbs, Shield-B_SilkS.gbo, Shield-Back.gbl, Shield-Edge_Cuts.gbr, Shield-F_Cu.gtl, Shield-F_Mask.gts, Shield-F_Paste.gtp]
2015-07-17 SP2525A spec clarified to make it clear that the SP2525A-1 is the correct USB power chip.
    [Comms.sch, Duet0.8.csv, Duet0.8.sch, Headers.sch, Htr_Fan.sch, Power.sch, Processor.sch, Stepper_Drv.sch]
2015-07-22 Library modified to add correct holes for the spade connectors.
    [Duet0.8-B_Mask.gbs, Duet0.8-B_SilkS.gbo, Duet0.8-Back.gbl, Duet0.8-Edge_Cuts.gbr, Duet0.8-F_Mask.gts, Duet0.8-F_Paste.gtp, Duet0.8-F_SilkS.gto, Duet0.8-Front.gtl]
2015-07-23 Back silk error fixed.
    [Duet0.8-B_Mask.gbs, Duet0.8-B_SilkS.gbo, Duet0.8-Back.gbl, Duet0.8-Edge_Cuts.gbr, Duet0.8-F_Mask.gts, Duet0.8-F_Paste.gtp, Duet0.8-F_SilkS.gto, Duet0.8-Front.gtl]
2015-08-14 Made change from RST pin to V_IN pin on header clearer on back silk.
    [Duet0.8-B_Mask.gbs, Duet0.8-B_SilkS.gbo, Duet0.8-Back.gbl, Duet0.8-Edge_Cuts.gbr, Duet0.8-F_Mask.gts, Duet0.8-F_Paste.gtp, Duet0.8-F_SilkS.gto, Duet0.8-Front.gtl]
2015-08-14 Created Duet1.0 as a copy of Duet0.8. Duet0.8 is now in the Archive.
    [Comms.sch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]
2015-08-14 Work-in-progress: Adding JMG's clean 5V buck converter.
    [Comms.sch, Duet1.0.brd, Duet1.0.csv, Duet1.0.sch, Headers.sch, Htr_Fan.sch, Power.sch, Processor.sch]
2015-08-18 First complete version 1.0 with new 5V buck converter.
    [Duet1.0-B_Mask.gbs, Duet1.0-B_SilkS.gbo, Duet1.0-Back.gbl, Duet1.0-Edge_Cuts.gbr, Duet1.0-F_Mask.gts, Duet1.0-F_Paste.gtp, Duet1.0-F_SilkS.gto, Duet1.0-Front.gtl]
2015-08-18 Added a couple of labels to the back of the board.
    [Duet1.0-B_Mask.gbs, Duet1.0-B_SilkS.gbo, Duet1.0-Back.gbl, Duet1.0-Edge_Cuts.gbr, Duet1.0-F_Mask.gts, Duet1.0-F_Paste.gtp, Duet1.0-F_SilkS.gto, Duet1.0-Front.gtl]
2015-08-18 Now with added ground plane on the back as well as the main one on Inner 2.
    [Duet1.0-B_Mask.gbs, Duet1.0-B_SilkS.gbo, Duet1.0-Back.gbl, Duet1.0-Edge_Cuts.gbr, Duet1.0-F_Mask.gts, Duet1.0-F_Paste.gtp, Duet1.0-F_SilkS.gto, Duet1.0-Front.gtl]
2015-08-27 Buck converter layout modified to fatten tracks and enhance grounds.
    [Comms.sch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]
2015-08-28 Buck layout improved.
    [Duet1.0-B_Mask.gbs, Duet1.0-B_SilkS.gbo, Duet1.0-Back.gbl, Duet1.0-Edge_Cuts.gbr, Duet1.0-F_Mask.gts, Duet1.0-F_Paste.gtp, Duet1.0-F_SilkS.gto, Duet1.0-Front.gtl]
2015-09-15 5 v freg gerber chopped out for testing.
2015-10-08 Making 5V buck using more readily available components; also smaller ones to fit them in.
    [Comms.sch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]
2015-10-08 5V buck gerber cut out for testing.
    [five-v-buck.gtl]
2015-10-17 470uF cap on 5v buck converter replaced by 2 x 220uF.
    [Comms.sch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]
2015-10-17 5v buck singled out in its own gerber for testing.
2015-10-28 Final tidying before getting Duet 1.0 prototypes.
    [Duet1.0-B_Mask.gbs, Duet1.0-B_SilkS.gbo, Duet1.0-Back.gbl, Duet1.0-Edge_Cuts.gbr, Duet1.0-F_Mask.gts, Duet1.0-F_Paste.gtp, Duet1.0-F_SilkS.gto, Duet1.0-Front.gtl]
2015-11-03 Duet-1.0.csv BoM with footprints added. Thanks to Marc Le Douarain and http://www.kicadlib.org/Fichiers/KicadComponentsListToCsv_v0_1.zip
    [Duet1.0.csv]
